jmshearer/UselessBoxWithLED/NOTICES.md

# Third-Party Notices

This project incorporates material from the projects listed below. The original material was modified to create derived material used in this project. The kind gesture of these open-source contributors is gratefully acknowledged.

---

## Useless Arduino Model
- **License**: [Creative Commons - Attribution - Share Alike license](https://creativecommons.org/licenses/by-sa/3.0/)
- **Source**: [Thingiverse](https://www.thingiverse.com/thing:415296)
- **Author**: SjFleischmann

**You are free to:**
- Share — copy and redistribute the material in any medium or format for any purpose, even commercially.
- Adapt — remix, transform, and build upon the material for any purpose, even commercially.

The licensor cannot revoke these freedoms as long as you follow the license terms.

**Under the following terms:**
- Attribution — You must give appropriate credit , provide a link to the license, and indicate if changes were made . You may do so in any reasonable manner, but not in any way that suggests the licensor endorses you or your use.
- ShareAlike — If you remix, transform, or build upon the material, you must distribute your contributions under the same license as the original.

No additional restrictions — You may not apply legal terms or technological measures that legally restrict others from doing anything the license permits.

**Notices:**
You do not have to comply with the license for elements of the material in the public domain or where your use is permitted by an applicable exception or limitation.

No warranties are given. The license may not give you all of the permissions necessary for your intended use. For example, other rights such as publicity, privacy, or moral rights may limit how you use the material.
