jmshearer/UselessBoxWithLED/Model/Useless Case.stl

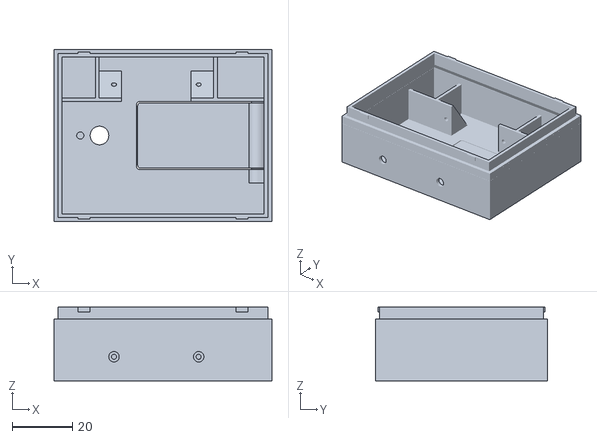
[picture p4: CAD file, 2024-01-11]
Model/Useless Case.stl
72.6 x 57.3 x 24.5
