jmshearer/UselessBoxWithLED/Model/Bottom.stl

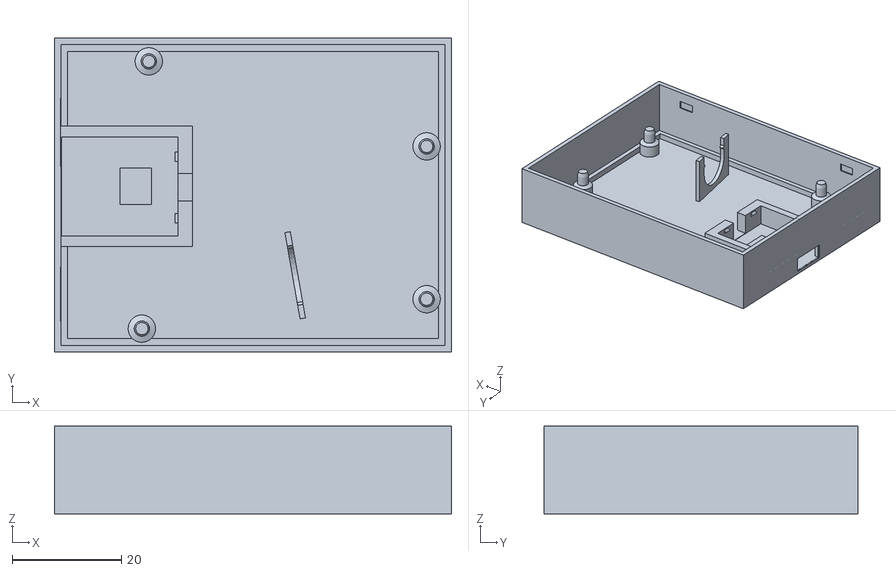
[picture p5: CAD file, 2024-01-11]
Model/Bottom.stl
72.6 x 57.3 x 16.0
