jmshearer/UselessBoxWithLED/Model/Useless_Arduino_Case.stl

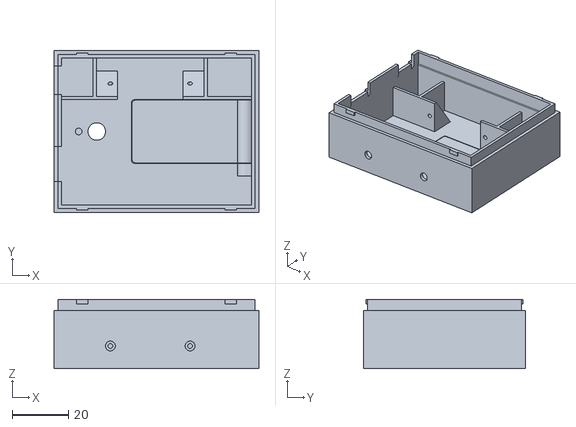
[picture p6: CAD file, 2024-01-07]
Model/Useless_Arduino_Case.stl
72.6 x 57.3 x 24.5
