jmshearer/UselessBoxWithLED/Model/Useless_Arduino_Lever.stl

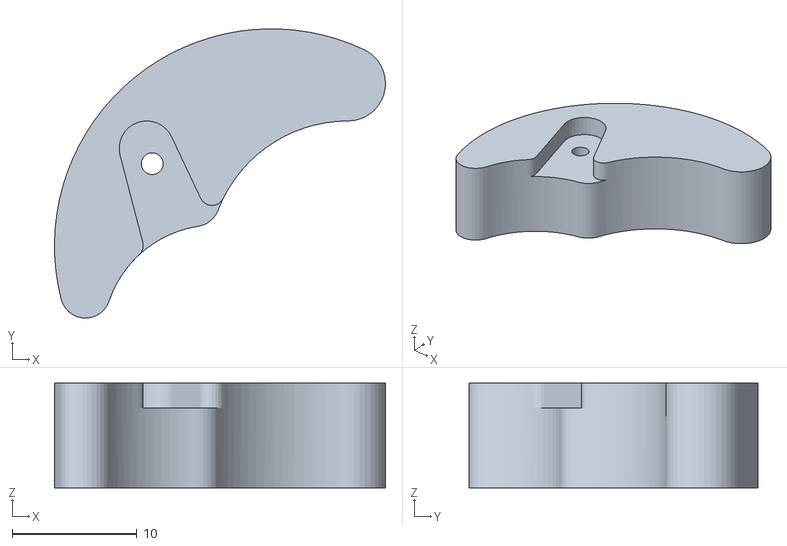
[picture p7: CAD file, 2024-01-07]
Model/Useless_Arduino_Lever.stl
26.5 x 23.2 x 8.40
