jmshearer/UselessBoxWithLED/Model/Lever-Modified.stl

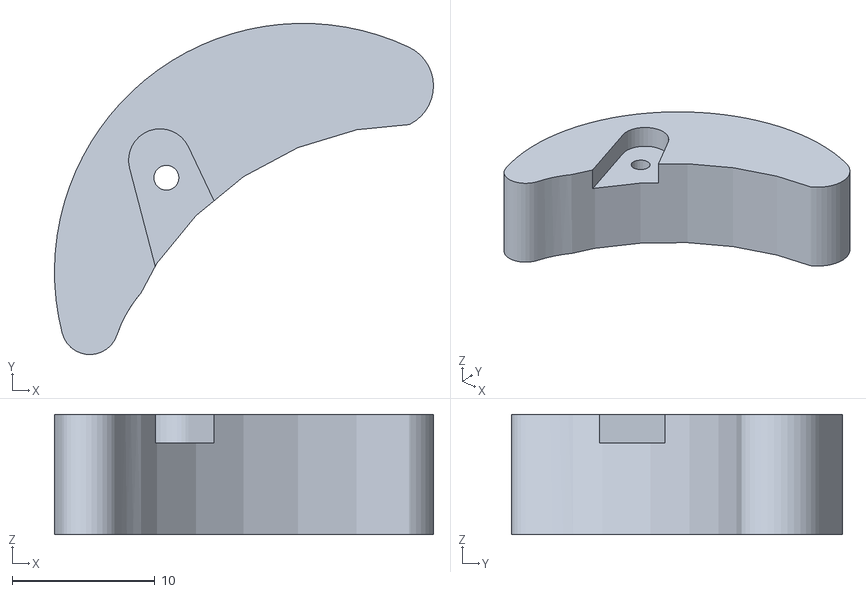
[picture p8: CAD file, 2024-01-07]
Model/Lever-Modified.stl
26.5 x 23.2 x 8.40
