jmshearer/UselessBoxWithLED/Model/arduino-case_bottom.stl

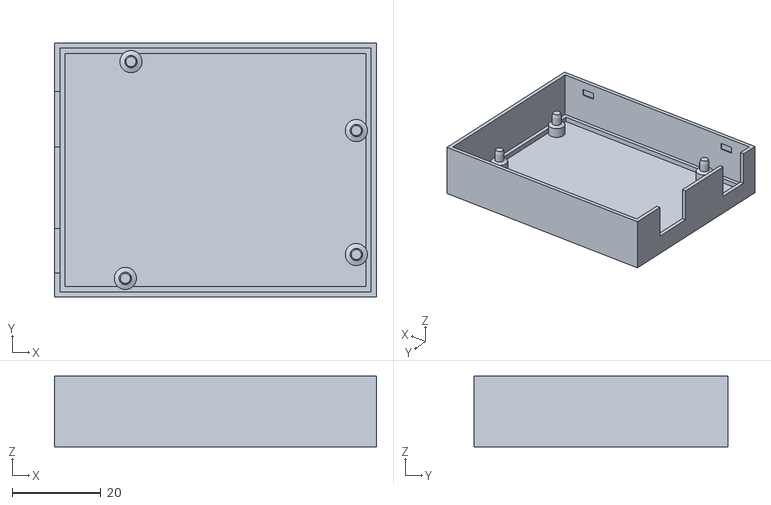
[picture p9: CAD file, 2024-01-07]
Model/arduino-case_bottom.stl
72.6 x 57.3 x 16.0
