jmshearer/UselessBoxWithLED/(list of files, cad)

Other CAD files:
Model/Useless_Arduino_Case_0.4mmGap.stl
Model/Useless_Arduino_Case_0.3mmGap.stl
Model/Arm.blend
Model/Bottom.blend
Model/Useless Case 1.blend
