jmshearer/UselessBoxWithLED/(commit log)

2024-01-10 Clean up files
    [Arm.blend, Bottom.blend, Bottom.stl, Lever-Modified.stl, Useless Case - Joanna.blend, Useless Case - Joanna.stl, Useless Case 1.blend, Useless_Arduino_Case.stl]
2024-01-11 Add led holder
    [Bottom.blend, Bottom.stl, LED Holder.blend, Useless Case - Joanna.blend, Useless Case.blend, Useless Case.stl]
2024-01-13 Update to work with ESP32
2024-01-13 Rename Arduino Code
2024-01-13 Remove some old blend files
    [Arm.blend, Bottom.blend, Bottom.stl, LED Holder.blend, Lever-Modified.stl, Useless Case - Joanna.blend, Useless Case - Joanna.stl, Useless Case 1.blend]
2024-01-13 Update schematic
